MakerControls/Paragon/README.md

# Paragon
300A+, 36V DC Brushed Motor Controller for Arduino
