MakerControls/Paragon/ParagonMk1_1/ParagonMk1_1-BOM.xls

Paragon Mk 1.1 BOM
Component Description | Designation | Package | Value | Manufacturer | Model Number | Quantity | Notes
Ceramic Capacitor | C1-C7 | 0.2" lead spacing | 1uF, 50V | various | various | 7
Ceramic Capacitor | C8-C12 | 0.2" lead spacing | 0.1uF, 50V | various | various | 5
Ceramic Capacitor | C13-C14 | 0.2" lead spacing | 0.68uF, 25V | various | various | 2
Ceramic Capacitor | C15 | 0.2" lead spacing | 13.6uF, 16V | various | various | 1
Ceramic Capacitor | C16 | 0.2" lead spacing | 0.47uF, 25V | various | various | 1
Electrolytic Capacitor | CIN, COUT | E3.5-8 | 100uF, 50V | United Chemi-Con | EKZE500ELL101MHB5D | 2
Electrolytic Capacitor | n/a | 16x25mm | 1000uF, 50V | United Chemi-Con | EKZE500ELL102ML25S | 4 | Bulk Capacitors
Diode | D1, D3 | DO-35 | 100V, 4A | On Semi | 1N4148 | 2
Schottky Diode | D2, D4 | DO-41 | 20V, 1A | Rectron | 1N5817-B | 2
Zener Diode | D5 | DO-35 | 15V, 0.5W | On Semi | 1N5245B | 1
H-Bridge Driver | IC1 | TSSOP28 | A3941 | Allegro | A3941 | 1
Switching Regulator | IC2 | TO220-5 | 1A, 12V | TI | TL2575HV-ADJIKV | 1 | Provides 12V to Arduino and connector
LDO | IC3 | TO220-3 | 1A, 5V | On Semi | NCP7800 | 1 | Provides 5V to connectors
Inductor | L1 | Radial Case | 680uH, 1.1A | Abracon | AIUR-06-681K | 1
POWER N-MOSFET | M1-M12 | TO220 | 60V, 120A | Nexperia | PSMN2R0-60PS | 12
MOSFET N-Channel | M13 | TO-92 | 60V, 0.2A | On Semi | 2N7000 | 1
MOSFET P-Channel | M14 | 4-DIP | 60V, 1.6A | Vishay | IRFD9020 | 1
Gate Resistors | R1-R12 | 0.2" lead spacing | 10ohm | various | various | 12
Resistor | R13 | 0.2" lead spacing | 49.9K, 1% | various | various | 1 | Must be 1% or better
Resistor | R14 | 0.2" lead spacing | 5.6K, 1% | various | various | 1 | Must be 1% or better
Resistor | R15-R18, R35 | 0.2" lead spacing | 100K | various | various | 5
Resistor | R19-R21, R24-R25, R28-R32, R36-R37 | 0.2" lead spacing | 10K | various | various | 12
Resistor | R22-R23, R33 | 0.2" lead spacing | 1K | various | various | 3
Resistor | R26 | 0.2" lead spacing | 0ohm | various | various | 1
Resistor | R27 | 0.2" lead spacing | 220ohm | various | various | 1
Resistor | R34 | 0.2" lead spacing | 3K | various | various | 1
Status LED | STATUS | 3mm LED, 0.1" lead spacing |  | various | various | 1
Switch | SW1 |  | 125V, 0.25A SPDT | TE | SLS121RA04 | 1 | Turns on switching regulator
Connector - Jacks | J1, J2, J3 |  |  | JST | S10B-PADSS-1 | 3
Connector - Plugs | P1, P2, P3 |  |  | JST | PADP-10V-1-S | 3
Connector - Pins | n/a |  |  | JST | SPH-001T-P0.5L | 30
Arduino Headers | n/a | 0.1" pitch, 1 row | 25 pins total |  |  | 1 | Use generic 0.1" single row breakaway headers
Jumper Headers | JP1-JP5 | 0.1" pitch, 2 rows | 4Pin breakaway headers |  |  | 5 | Use generic 0.1" two row breakaway headers
Jumper | n/a |  |  |  |  | 5 | Use generic 0.1" jumpers
Arduino Uno | n/a |  |  | Arduino | Uno R3 | 1
Mechanical Components | Dimensions | Material |  |  |  | Quantity
Bus Bars | 8mmx20mm | Aluminum |  |  |  | 3 | Cut to 100mm length
Ground Plane | 5"x4"1/4" | Aluminum |  |  |  | 1
MOSFET to Bus Bar Bolt | 4/40 x 1/4" | Stainless Steel |  |  |  | 12
PCB to GND Plane Bolt | 6/32 x 1-1/4" | Brass |  |  |  | 10
Unthreaded Standoff | 0.92" long, #6 Screw size | Nylon |  |  |  | 4 | Corner bolts only
PCB to Bus Bar Bolt | 6/32 x 3/8" | Brass |  |  |  | 6
Other
Thermal Sheet |  |  |  | t-Global Technology | L37-3F-640-320-0.45-1A |  | Cut to fit between bus bars and ground plane
Thermal Paste |  |  | Arctic Silver 5 or similar | various | various |  | Apply small amount between TO220 and bus bars
