MakerControls/Paragon/ParagonMk1_1/Pinouts.xls

Paragon Mk1.1 Connector Pinout
Connector | Pin | Signal
J1 | 1 | +5V
J1 | 2 | GND
J1 | 3 | BRAKESENSE
J1 | 4 | n/c
J1 | 5 | +5V
J1 | 6 | GND
J1 | 7 | SPEEDLIMITSENSE
J1 | 8 | +5V
J1 | 9 | GND
J1 | 10 | CURRENTSENSE
J2 | 1 | +5V
J2 | 2 | GND
J2 | 3 | THROTTLESENSE
J2 | 4 | n/c
J2 | 5 | +5V
J2 | 6 | GND
J2 | 7 | DIRECTIONSENSE
J2 | 8 | n/c
J2 | 9 | n/c
J2 | 10 | n/c
J3 | 1 | +5V
J3 | 2 | GND
J3 | 3 | n/c
J3 | 4 | LED_STATUS_OUT
J3 | 5 | RX
J3 | 6 | TX
J3 | 7 | RESET_IN
J3 | 8 | GND
J3 | 9 | V+PROT
J3 | 10 | GND
