MakerControls/Paragon/ParagonMk1_1/ParagonMk1_1-Schematic.pdf

Tri H-Bridge | I/O Connectors

# Motor Controller

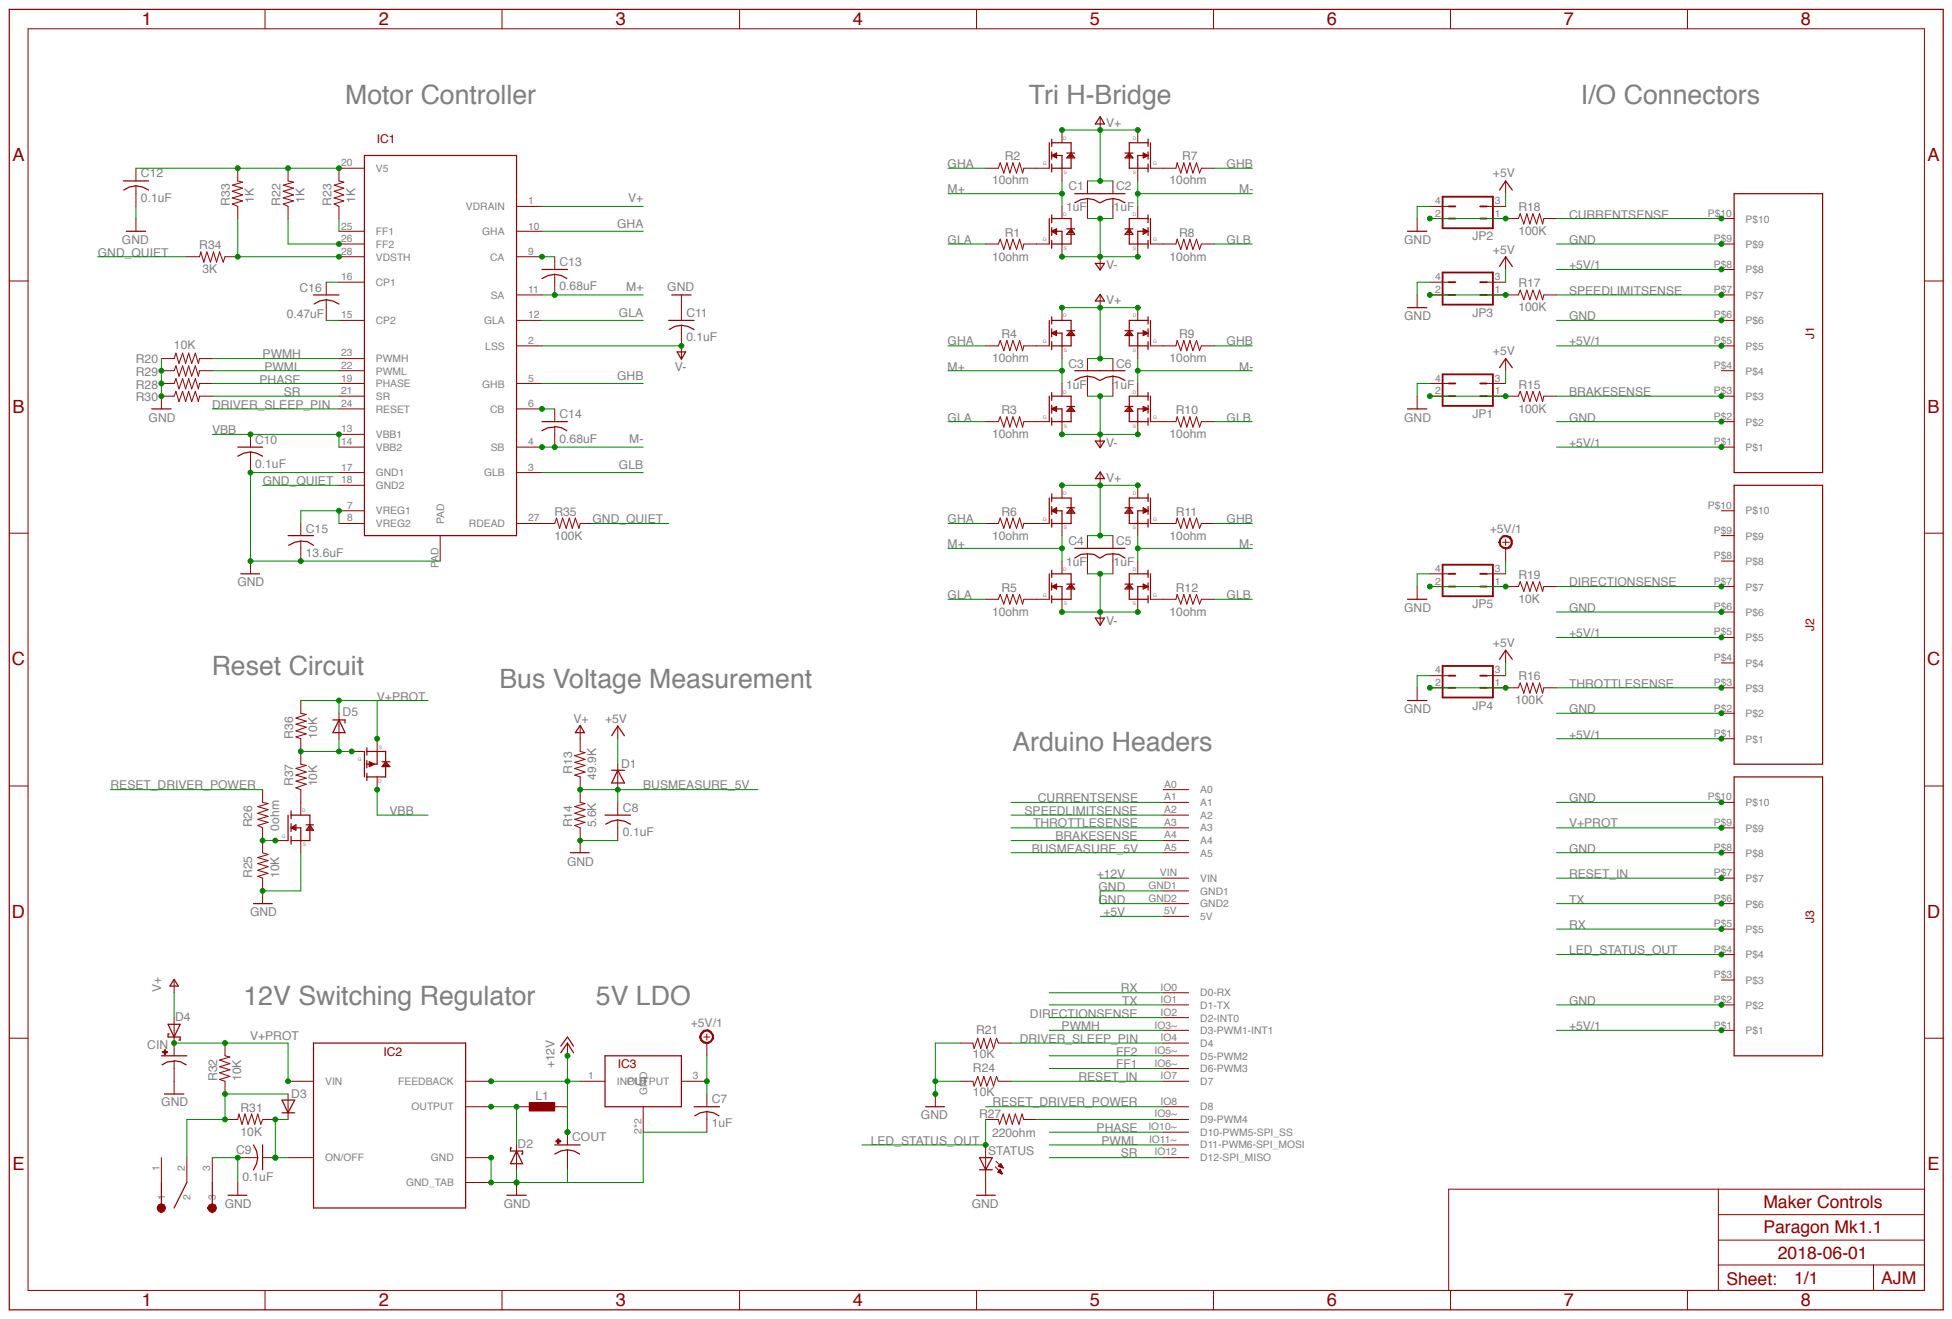
[picture p1: page 1]
