MakerControls/Paragon/(commit log)

2018-06-01 Initial commit of GERBER files, BOM, pinout, and code
    [Configuration.h, ParagonMk1_1-BOM.xls, Pinouts.xls]
2019-01-28 Added Schematic
